Graduation-Project-2027/Framework-Subteam/RaspberryPi_ROS2/images/gui-mapping-bar.png

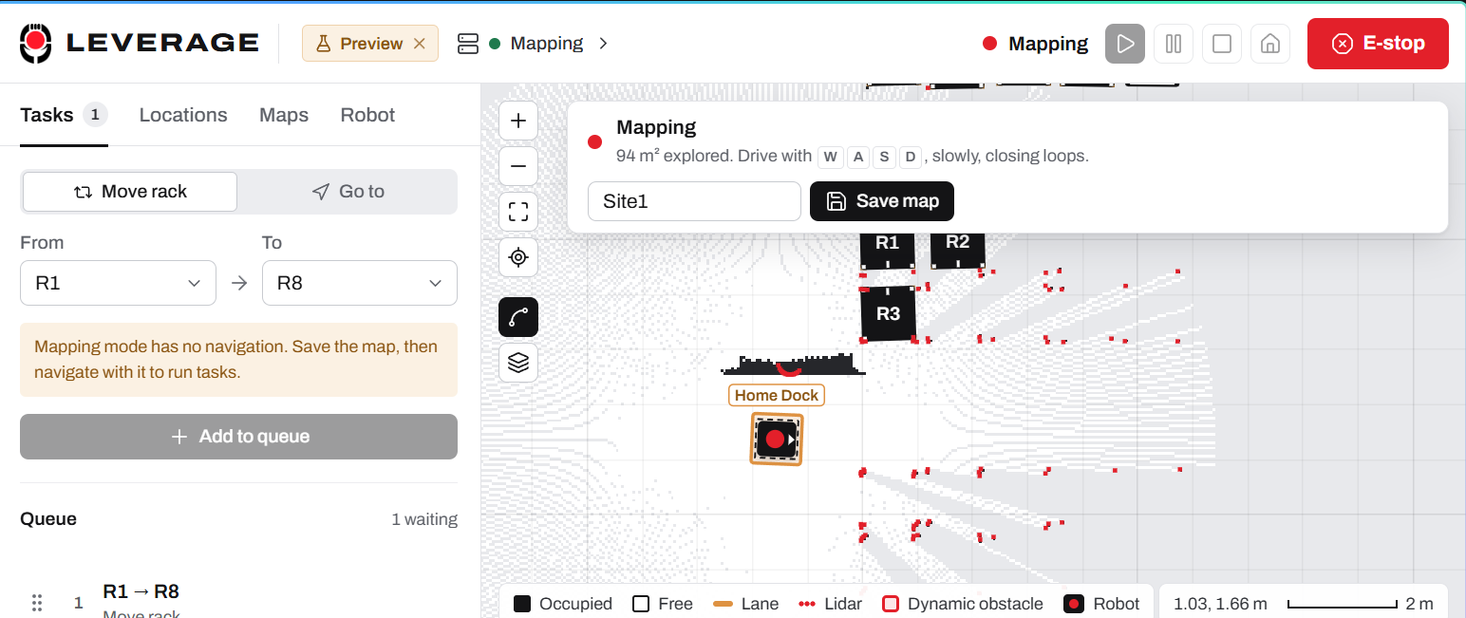
RaspberryPi_ROS2/images/gui-mapping-bar.png
