Graduation-Project-2027/Framework-Subteam/RaspberryPi_ROS2/images/gui-mapping-zoomed.png

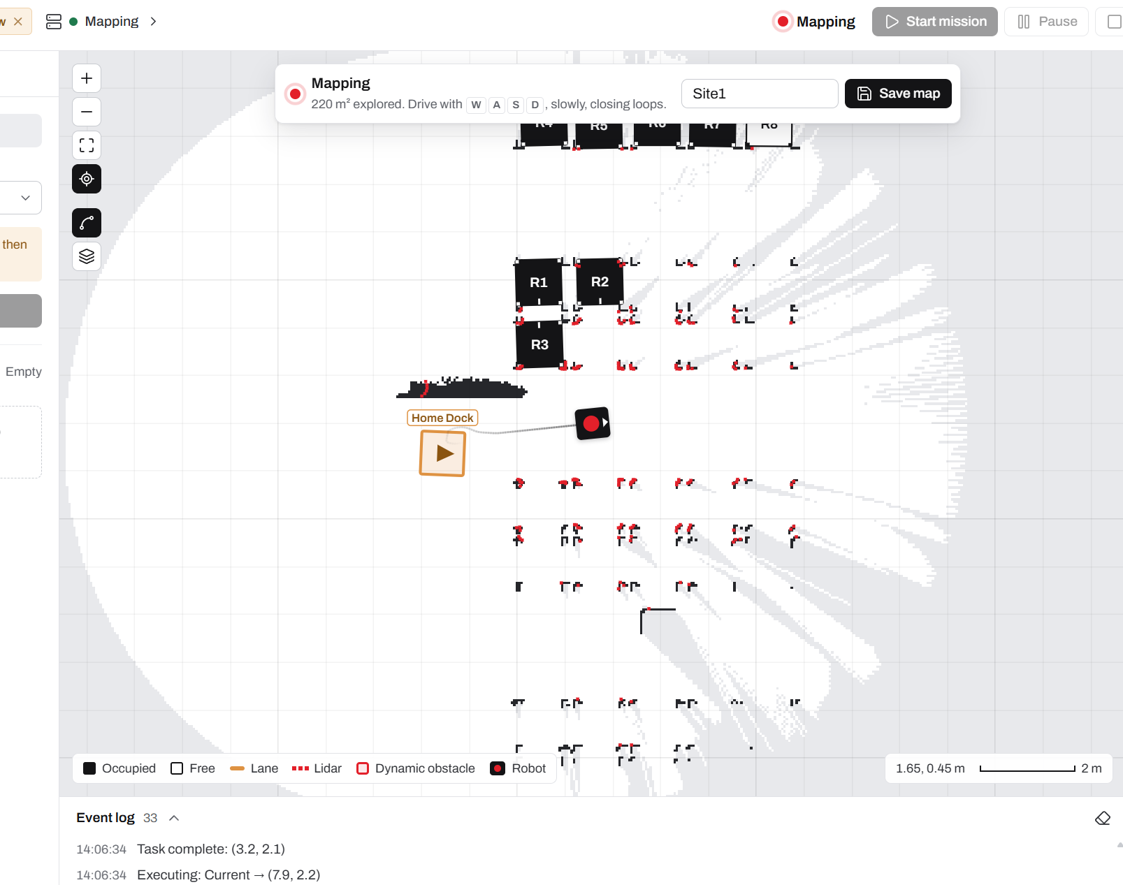
RaspberryPi_ROS2/images/gui-mapping-zoomed.png
