Graduation-Project-2027/Framework-Subteam/src/agv_description/models/loading_zone/materials/textures/loading_area.png

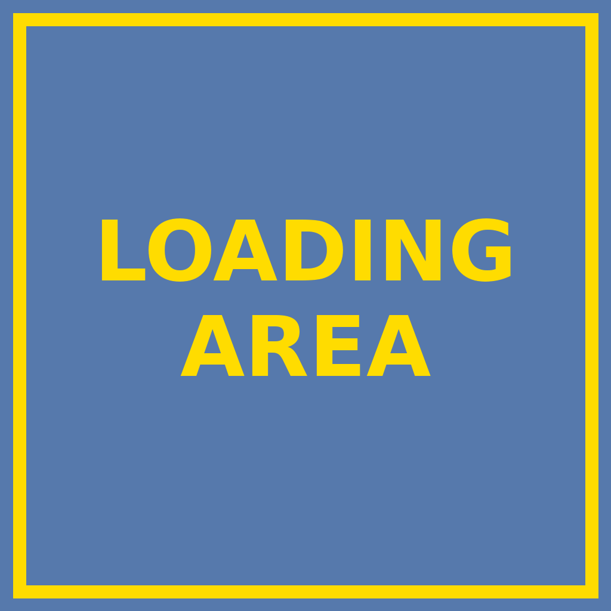
src/agv_description/models/loading_zone/materials/textures/loading_area.png
