Graduation-Project-2027/Framework-Subteam/RaspberryPi_ROS2/src/agv_description/meshes/lift_v2/bar1_back_left.STL

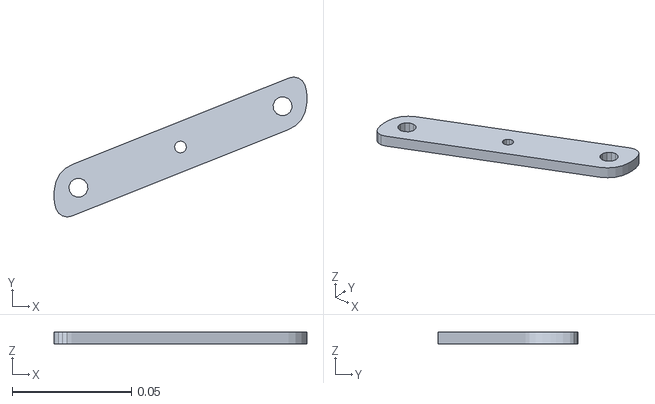
[picture p26: CAD file, 2026-10-28]
RaspberryPi_ROS2/src/agv_description/meshes/lift_v2/bar1_back_left.STL
0.106 x 0.0586 x 0.005
