Graduation-Project-2027/Framework-Subteam/src/mecanum_robot_description/meshes/robot_3d/visual/lifting_mechanism.stl

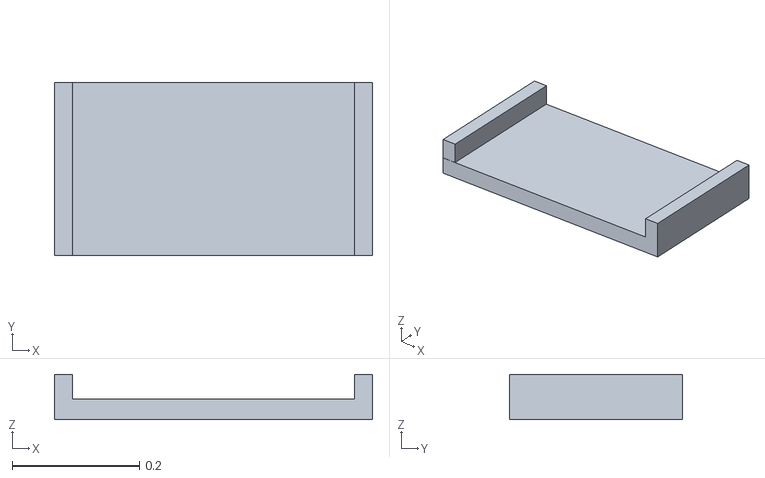
[picture p27: CAD file, 2026-03-07]
src/mecanum_robot_description/meshes/robot_3d/visual/lifting_mechanism.stl
0.501 x 0.273 x 0.0711
