Graduation-Project-2027/Framework-Subteam/RaspberryPi_ROS2/src/agv_description/meshes/lift_v2/base_link.STL

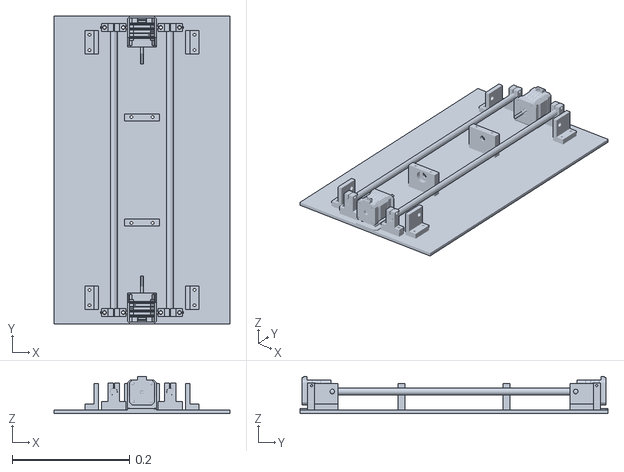
[picture p28: CAD file, 2026-10-28]
RaspberryPi_ROS2/src/agv_description/meshes/lift_v2/base_link.STL
0.3 x 0.525 x 0.0633
