Graduation-Project-2027/Framework-Subteam/src/mecanum_robot_description/meshes/robot_3d/visual/front_right_wheel_X3.STL

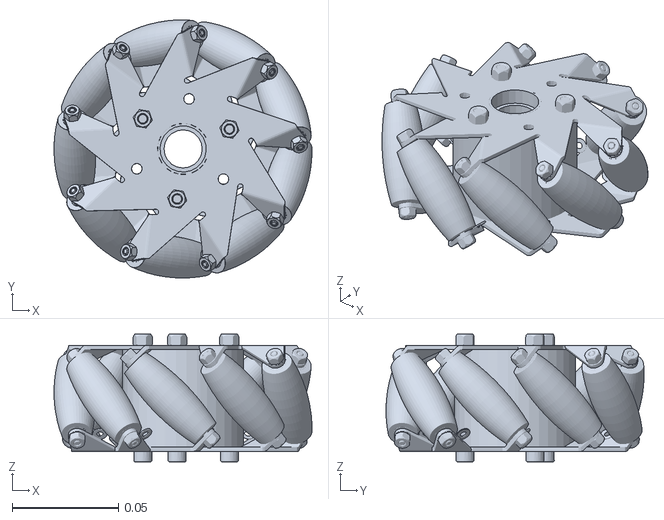
[picture p29: CAD file, 2026-03-05]
src/mecanum_robot_description/meshes/robot_3d/visual/front_right_wheel_X3.STL
0.122 x 0.122 x 0.0603
