Graduation-Project-2027/Framework-Subteam/src/New_Lift_Design/meshes/table_link.STL

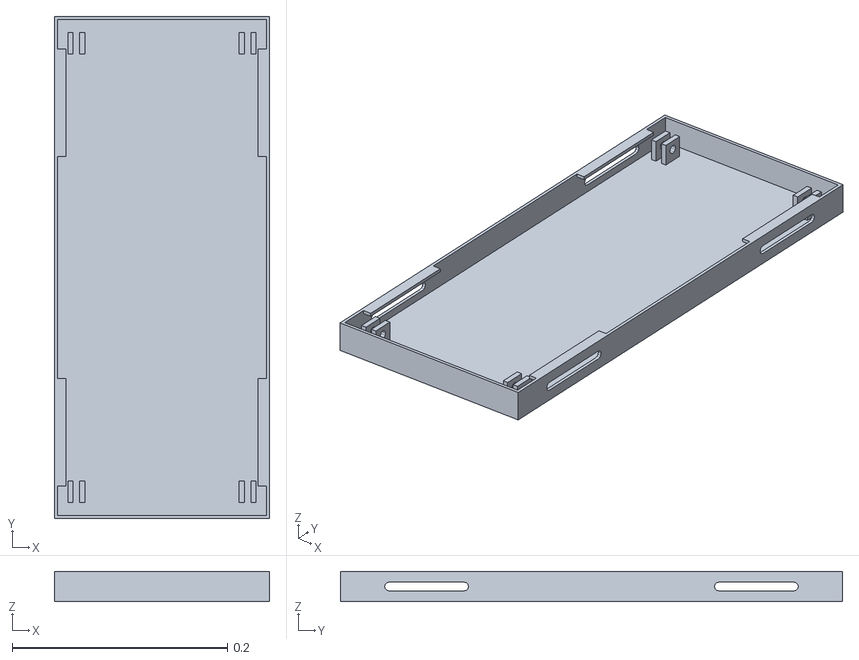
[picture p30: CAD file, 2026-06-20]
src/New_Lift_Design/meshes/table_link.STL
0.2 x 0.467 x 0.028
