Graduation-Project-2027/Framework-Subteam/RaspberryPi_ROS2/src/New_Lift_Design/meshes/lead_screw_left.STL

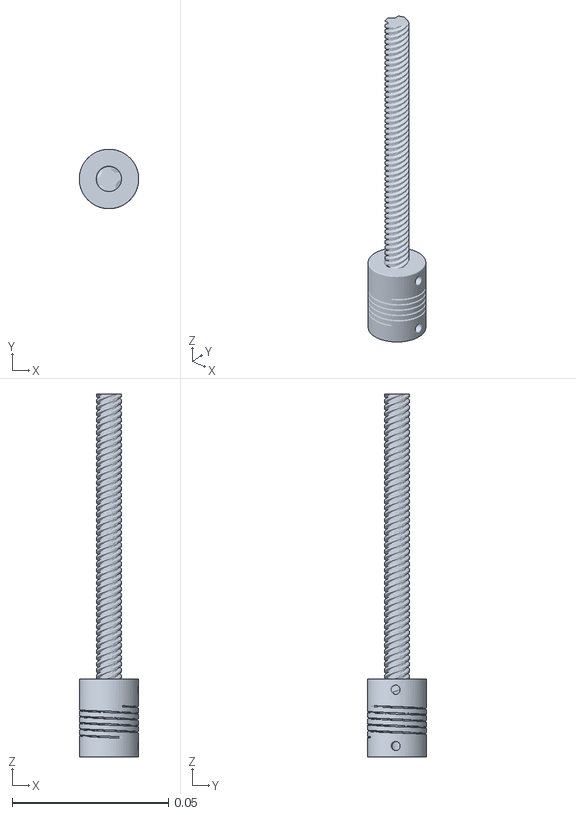
[picture p31: CAD file, 2026-10-28]
RaspberryPi_ROS2/src/New_Lift_Design/meshes/lead_screw_left.STL
0.019 x 0.019 x 0.116
