Graduation-Project-2027/Framework-Subteam/RaspberryPi_ROS2/src/amr_description/meshes/lift_v2/nut_left.STL

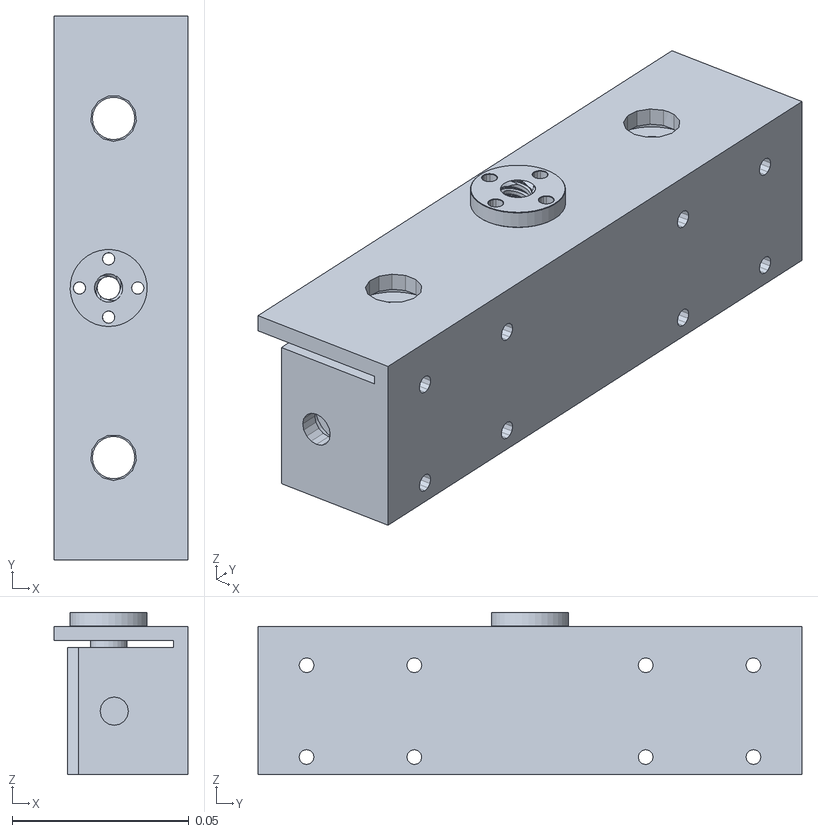
[picture p32: CAD file, 2026-10-28]
RaspberryPi_ROS2/src/amr_description/meshes/lift_v2/nut_left.STL
0.0378 x 0.154 x 0.046
