Graduation-Project-2027/Framework-Subteam/(list of files, cad)

Other CAD files:
RaspberryPi_ROS2/src/amr_description/meshes/lift_v2/bar2_back_right.STL
src/New_Lift_Design/meshes/bar2_front_right.STL
RaspberryPi_ROS2/src/New_Lift_Design/meshes/bar2_front_left.STL
src/agv_description/meshes/lift_v2/bar2_back_left.STL
RaspberryPi_ROS2/src/New_Lift_Design/meshes/bar1_back_right.STL
src/agv_description/meshes/lift_v2/bar1_front_right.STL
src/mecanum_robot_description/meshes/robot_3d/visual/back_right_wheel_X3.STL
src/New_Lift_Design/meshes/bar1_front_left.STL
src/mecanum_robot_description/meshes/robot_3d/visual/back_left_wheel_X3.STL
src/mecanum_robot_description/meshes/robot_3d/visual/front_left_wheel_X3.STL
src/agv_description/meshes/lift_v2/lead_screw_right.STL
OLD/mission_simulation/worlds/shelving_unit_warehouse.obj
src/New_Lift_Design/install_old/3dprototype_urdf/share/3dprototype_urdf/meshes/nut_right.STL
