Graduation-Project-2027/Framework-Subteam/RaspberryPi_ROS2/src/New_Lift_Design/build_old/3dprototype_urdf/install_manifest.txt

/home/omar/Desktop/3dprototype_urdf/install/3dprototype_urdf/share/3dprototype_urdf/config/joint_names_3dprototype_urdf.yaml
/home/omar/Desktop/3dprototype_urdf/install/3dprototype_urdf/share/3dprototype_urdf/launch/display.launch.py
/home/omar/Desktop/3dprototype_urdf/install/3dprototype_urdf/share/3dprototype_urdf/launch/gazebo.launch.py
/home/omar/Desktop/3dprototype_urdf/install/3dprototype_urdf/share/3dprototype_urdf/launch/__pycache__/display.launch.cpython-312.pyc
/home/omar/Desktop/3dprototype_urdf/install/3dprototype_urdf/share/3dprototype_urdf/launch/__pycache__/gazebo.launch.cpython-312.pyc
/home/omar/Desktop/3dprototype_urdf/install/3dprototype_urdf/share/3dprototype_urdf/meshes/base_link.STL
/home/omar/Desktop/3dprototype_urdf/install/3dprototype_urdf/share/3dprototype_urdf/meshes/nut_right.STL
/home/omar/Desktop/3dprototype_urdf/install/3dprototype_urdf/share/3dprototype_urdf/meshes/lead_screw_left.STL
/home/omar/Desktop/3dprototype_urdf/install/3dprototype_urdf/share/3dprototype_urdf/meshes/bar1_front_left.STL
/home/omar/Desktop/3dprototype_urdf/install/3dprototype_urdf/share/3dprototype_urdf/meshes/bar2_back_left.STL
/home/omar/Desktop/3dprototype_urdf/install/3dprototype_urdf/share/3dprototype_urdf/meshes/bar1_back_left.STL
/home/omar/Desktop/3dprototype_urdf/install/3dprototype_urdf/share/3dprototype_urdf/meshes/bar2_front_left.STL
/home/omar/Desktop/3dprototype_urdf/install/3dprototype_urdf/share/3dprototype_urdf/meshes/table_link.STL
/home/omar/Desktop/3dprototype_urdf/install/3dprototype_urdf/share/3dprototype_urdf/meshes/bar2_back_right.STL
/home/omar/Desktop/3dprototype_urdf/install/3dprototype_urdf/share/3dprototype_urdf/meshes/nut_left.STL
/home/omar/Desktop/3dprototype_urdf/install/3dprototype_urdf/share/3dprototype_urdf/meshes/bar1_front_right.STL
/home/omar/Desktop/3dprototype_urdf/install/3dprototype_urdf/share/3dprototype_urdf/meshes/lead_screw_right.STL
/home/omar/Desktop/3dprototype_urdf/install/3dprototype_urdf/share/3dprototype_urdf/meshes/bar2_front_right.STL
/home/omar/Desktop/3dprototype_urdf/install/3dprototype_urdf/share/3dprototype_urdf/meshes/bar1_back_right.STL
/home/omar/Desktop/3dprototype_urdf/install/3dprototype_urdf/share/3dprototype_urdf/rviz/urdf.rviz
/home/omar/Desktop/3dprototype_urdf/install/3dprototype_urdf/share/3dprototype_urdf/urdf/3dprototype_urdf.csv
/home/omar/Desktop/3dprototype_urdf/install/3dprototype_urdf/share/3dprototype_urdf/urdf/3dprototype_urdf.urdf
/home/omar/Desktop/3dprototype_urdf/install/3dprototype_urdf/share/3dprototype_urdf/urdf/3dprototype_urdf_control.urdf
/home/omar/Desktop/3dprototype_urdf/install/3dprototype_urdf/share/3dprototype_urdf/worlds/empty.sdf
/home/omar/Desktop/3dprototype_urdf/install/3dprototype_urdf/lib/3dprototype_urdf/scissor_mechanism_publisher.py
/home/omar/Desktop/3dprototype_urdf/install/3dprototype_urdf/share/3dprototype_urdf/package.xml
/home/omar/Desktop/3dprototype_urdf/install/3dprototype_urdf/share/ament_index/resource_index/packages/3dprototype_urdf
/home/omar/Desktop/3dprototype_urdf/install/3dprototype_urdf/share/ament_index/resource_index/package_run_dependencies/3dprototype_urdf
/home/omar/Desktop/3dprototype_urdf/install/3dprototype_urdf/share/ament_index/resource_index/parent_prefix_path/3dprototype_urdf
/home/omar/Desktop/3dprototype_urdf/install/3dprototype_urdf/share/3dprototype_urdf/environment/ament_prefix_path.sh
/home/omar/Desktop/3dprototype_urdf/install/3dprototype_urdf/share/3dprototype_urdf/environment/ament_prefix_path.dsv
/home/omar/Desktop/3dprototype_urdf/install/3dprototype_urdf/share/3dprototype_urdf/environment/path.sh
/home/omar/Desktop/3dprototype_urdf/install/3dprototype_urdf/share/3dprototype_urdf/environment/path.dsv
/home/omar/Desktop/3dprototype_urdf/install/3dprototype_urdf/share/3dprototype_urdf/local_setup.bash
/home/omar/Desktop/3dprototype_urdf/install/3dprototype_urdf/share/3dprototype_urdf/local_setup.sh
/home/omar/Desktop/3dprototype_urdf/install/3dprototype_urdf/share/3dprototype_urdf/local_setup.zsh
/home/omar/Desktop/3dprototype_urdf/install/3dprototype_urdf/share/3dprototype_urdf/local_setup.dsv
/home/omar/Desktop/3dprototype_urdf/install/3dprototype_urdf/share/3dprototype_urdf/package.dsv
/home/omar/Desktop/3dprototype_urdf/install/3dprototype_urdf/share/ament_index/resource_index/packages/3dprototype_urdf
/home/omar/Desktop/3dprototype_urdf/install/3dprototype_urdf/share/3dprototype_urdf/cmake/3dprototype_urdfConfig.cmake
/home/omar/Desktop/3dprototype_urdf/install/3dprototype_urdf/share/3dprototype_urdf/cmake/3dprototype_urdfConfig-version.cmake
/home/omar/Desktop/3dprototype_urdf/install/3dprototype_urdf/share/3dprototype_urdf/package.xml
