Graduation-Project-2027/Framework-Subteam/src/agv_description/urdf/urdf/temp.urdf

<?xml version="1.0" ?>
<!-- =================================================================================== -->
<!-- |    This document was autogenerated by xacro from robot.urdf.xacro               | -->
<!-- |    EDITING THIS FILE BY HAND IS NOT RECOMMENDED                                 | -->
<!-- =================================================================================== -->
<robot name="agv" xmlns:gz="http://gazebosim.org/schema">
  <material name="black">
    <color rgba="0.0 0.0 0.0 1.0"/>
  </material>
  <material name="blue">
    <color rgba="0.0 0.0 0.8 1.0"/>
  </material>
  <material name="green">
    <color rgba="0.0 0.8 0.0 1.0"/>
  </material>
  <material name="grey">
    <color rgba="0.2 0.2 0.2 1.0"/>
  </material>
  <material name="orange">
    <color rgba="1.0 0.4235294117647059 0.0392156862745098 1.0"/>
  </material>
  <material name="brown">
    <color rgba="0.8705882352941177 0.8117647058823529 0.7647058823529411 1.0"/>
  </material>
  <material name="red">
    <color rgba="0.8 0.0 0.0 1.0"/>
  </material>
  <material name="white">
    <color rgba="1.0 1.0 1.0 1.0"/>
  </material>
  <link name="base_footprint"/>
  <link name="base_link">
    <visual>
      <geometry>
        <mesh filename="file:///home/som3a-station/prjs/Grad/Framework-Subteam/install/agv_description/share/agv_description/meshes/robot_3d/visual/base_link.STL"/>
      </geometry>
      <material name="white">
        <color rgba="1 1 1 1"/>
      </material>
      <origin rpy="0 0 0" xyz="0 0 0"/>
    </visual>
    <collision>
      <geometry>
        <box size="0.7 0.51984 0.18"/>
      </geometry>
      <origin rpy="0 0 0" xyz="0.0 0 0.09"/>
    </collision>
    <inertial>
      <origin rpy="0 0 0" xyz="0.0 0 0.06968333333333333"/>
      <mass value="20"/>
      <inertia ixx="0.5043893759999999" ixy="0.0" ixz="0.0" iyy="0.8706666666666666" iyz="0.0" izz="1.2670560426666664"/>
    </inertial>
  </link>
  <gazebo reference="base_link">
    <visual>
      <material>
        <ambient>0 0.7 0 1</ambient>
        <diffuse>0 0.7 0 1</diffuse>
        <specular>0 0.7 0 1</specular>
      </material>
    </visual>
  </gazebo>
  <joint name="base_joint" type="fixed">
    <parent link="base_footprint"/>
    <child link="base_link"/>
    <origin rpy="0 0 0" xyz="0 0 0.035739999999999994"/>
  </joint>
  <link name="lift_link">
    <visual>
      <origin rpy="0 0 0" xyz="0 -0.25 0"/>
      <geometry>
        <mesh filename="file:///home/som3a-station/prjs/Grad/Framework-Subteam/install/agv_description/share/agv_description/meshes/robot_3d/visual/lifting_mechanism.stl"/>
      </geometry>
      <material name="silver">
        <color rgba="0.75 0.75 0.75 1"/>
      </material>
    </visual>
    <collision>
      <origin rpy="0 0 0" xyz="0 -0.25 0"/>
      <geometry>
        <mesh filename="file:///home/som3a-station/prjs/Grad/Framework-Subteam/install/agv_description/share/agv_description/meshes/robot_3d/visual/lifting_mechanism.stl"/>
      </geometry>
    </collision>
    <inertial>
      <origin rpy="0 0 0" xyz="0 0 0"/>
      <mass value="5.0"/>
      <inertia ixx="0.05" ixy="0" ixz="0" iyy="0.05" iyz="0" izz="0.05"/>
    </inertial>
  </link>
  <joint name="lift_joint" type="prismatic">
    <parent link="base_link"/>
    <child link="lift_link"/>
    <origin rpy="0 0 0" xyz="0 0 0.15"/>
    <axis xyz="0 0 1"/>
    <limit effort="200" lower="0" upper="0.5" velocity="0.2"/>
    <dynamics damping="15.0" friction="2.0"/>
  </joint>
  <transmission name="lift_trans">
    <type>transmission_interface/SimpleTransmission</type>
    <joint name="lift_joint">
      <hardwareInterface>hardware_interface/PositionJointInterface</hardwareInterface>
    </joint>
    <actuator name="lift_motor">
      <mechanicalReduction>1</mechanicalReduction>
    </actuator>
  </transmission>
  <gazebo reference="lift_link">
    <material>Gazebo/Grey</material>
  </gazebo>
  <link name="front_left_wheel_link">
    <visual>
      <origin rpy="0 0 0" xyz="0 0 -0.025"/>
      <geometry>
        <mesh filename="file:///home/som3a-station/prjs/Grad/Framework-Subteam/install/agv_description/share/agv_description/meshes/robot_3d/visual/front_left_wheel_X3.STL" scale="1 1 1"/>
      </geometry>
      <material name="dark_gray">
        <color rgba="0.2 0.2 0.2 1.0"/>
      </material>
    </visual>
    <collision>
      <origin rpy="0 0 0" xyz="0.0 0 0.025"/>
      <geometry>
        <cylinder length="0.06" radius="0.06095"/>
      </geometry>
    </collision>
    <inertial>
      <origin rpy="0 0 0" xyz="0.0 0 0"/>
      <mass value="2"/>
      <inertia ixx="0.0024574512499999997" ixy="0" ixz="0" iyy="0.0037149024999999997" iyz="0" izz="0.0024574512499999997"/>
    </inertial>
  </link>
  <joint name="front_left_wheel_joint" type="continuous">
    <axis xyz="0 0 -1"/>
    <parent link="base_link"/>
    <child link="front_left_wheel_link"/>
    <origin rpy="1.5707963267948966 1.5707963267948966 0" xyz="0.283 0.29491999999999996 0.02521"/>
  </joint>
  <gazebo reference="front_left_wheel_link">
    <surface>
      <friction>
        <ode>
          <mu>2.0</mu>
          <mu2>0.0</mu2>
        </ode>
      </friction>
    </surface>
    <visual>
      <material>
        <ambient>0.2 0.2 0.2 1.0</ambient>
        <diffuse>0.2 0.2 0.2 1.0</diffuse>
        <specular>0.2 0.2 0.2 1.0</specular>
        <emissive>0.0 0.0 0.0 0.0</emissive>
      </material>
    </visual>
  </gazebo>
  <link name="front_right_wheel_link">
    <visual>
      <origin rpy="0 0 0" xyz="0 0 -0.025"/>
      <geometry>
        <mesh filename="file:///home/som3a-station/prjs/Grad/Framework-Subteam/install/agv_description/share/agv_description/meshes/robot_3d/visual/front_right_wheel_X3.STL" scale="1 1 1"/>
      </geometry>
      <material name="dark_gray">
        <color rgba="0.2 0.2 0.2 1.0"/>
      </material>
    </visual>
    <collision>
      <origin rpy="0 0 0" xyz="0.0 0 0.025"/>
      <geometry>
        <cylinder length="0.06" radius="0.06095"/>
      </geometry>
    </collision>
    <inertial>
      <origin rpy="0 0 0" xyz="0.0 0 0"/>
      <mass value="2"/>
      <inertia ixx="0.0024574512499999997" ixy="0" ixz="0" iyy="0.0037149024999999997" iyz="0" izz="0.0024574512499999997"/>
    </inertial>
  </link>
  <joint name="front_right_wheel_joint" type="continuous">
    <axis xyz="0 0 1"/>
    <parent link="base_link"/>
    <child link="front_right_wheel_link"/>
    <origin rpy="-1.5707963267948966 1.5707963267948966 0" xyz="0.283 -0.29491999999999996 0.02521"/>
  </joint>
  <gazebo reference="front_right_wheel_link">
    <surface>
      <friction>
        <ode>
          <mu>2.0</mu>
          <mu2>0.0</mu2>
        </ode>
      </friction>
    </surface>
    <visual>
      <material>
        <ambient>0.2 0.2 0.2 1.0</ambient>
        <diffuse>0.2 0.2 0.2 1.0</diffuse>
        <specular>0.2 0.2 0.2 1.0</specular>
        <emissive>0.0 0.0 0.0 0.0</emissive>
      </material>
    </visual>
  </gazebo>
  <link name="back_left_wheel_link">
    <visual>
      <origin rpy="0 0 0" xyz="0 0 -0.025"/>
      <geometry>
        <mesh filename="file:///home/som3a-station/prjs/Grad/Framework-Subteam/install/agv_description/share/agv_description/meshes/robot_3d/visual/back_left_wheel_X3.STL" scale="1 1 1"/>
      </geometry>
      <material name="dark_gray">
        <color rgba="0.2 0.2 0.2 1.0"/>
      </material>
    </visual>
    <collision>
      <origin rpy="0 0 0" xyz="0.0 0 0.025"/>
      <geometry>
        <cylinder length="0.06" radius="0.06095"/>
      </geometry>
    </collision>
    <inertial>
      <origin rpy="0 0 0" xyz="0.0 0 0"/>
      <mass value="2"/>
      <inertia ixx="0.0024574512499999997" ixy="0" ixz="0" iyy="0.0037149024999999997" iyz="0" izz="0.0024574512499999997"/>
    </inertial>
  </link>
  <joint name="back_left_wheel_joint" type="continuous">
    <axis xyz="0 0 -1"/>
    <parent link="base_link"/>
    <child link="back_left_wheel_link"/>
    <origin rpy="1.5707963267948966 1.5707963267948966 0" xyz="-0.283 0.29491999999999996 0.02521"/>
  </joint>
  <gazebo reference="back_left_wheel_link">
    <surface>
      <friction>
        <ode>
          <mu>2.0</mu>
          <mu2>0.0</mu2>
        </ode>
      </friction>
    </surface>
    <visual>
      <material>
        <ambient>0.2 0.2 0.2 1.0</ambient>
        <diffuse>0.2 0.2 0.2 1.0</diffuse>
        <specular>0.2 0.2 0.2 1.0</specular>
        <emissive>0.0 0.0 0.0 0.0</emissive>
      </material>
    </visual>
  </gazebo>
  <link name="back_right_wheel_link">
    <visual>
      <origin rpy="0 0 0" xyz="0 0 -0.025"/>
      <geometry>
        <mesh filename="file:///home/som3a-station/prjs/Grad/Framework-Subteam/install/agv_description/share/agv_description/meshes/robot_3d/visual/back_right_wheel_X3.STL" scale="1 1 1"/>
      </geometry>
      <material name="dark_gray">
        <color rgba="0.2 0.2 0.2 1.0"/>
      </material>
    </visual>
    <collision>
      <origin rpy="0 0 0" xyz="0.0 0 0.025"/>
      <geometry>
        <cylinder length="0.06" radius="0.06095"/>
      </geometry>
    </collision>
    <inertial>
      <origin rpy="0 0 0" xyz="0.0 0 0"/>
      <mass value="2"/>
      <inertia ixx="0.0024574512499999997" ixy="0" ixz="0" iyy="0.0037149024999999997" iyz="0" izz="0.0024574512499999997"/>
    </inertial>
  </link>
  <joint name="back_right_wheel_joint" type="continuous">
    <axis xyz="0 0 1"/>
    <parent link="base_link"/>
    <child link="back_right_wheel_link"/>
    <origin rpy="-1.5707963267948966 1.5707963267948966 0" xyz="-0.283 -0.29491999999999996 0.02521"/>
  </joint>
  <gazebo reference="back_right_wheel_link">
    <surface>
      <friction>
        <ode>
          <mu>2.0</mu>
          <mu2>0.0</mu2>
        </ode>
      </friction>
    </surface>
    <visual>
      <material>
        <ambient>0.2 0.2 0.2 1.0</ambient>
        <diffuse>0.2 0.2 0.2 1.0</diffuse>
        <specular>0.2 0.2 0.2 1.0</specular>
        <emissive>0.0 0.0 0.0 0.0</emissive>
      </material>
    </visual>
  </gazebo>
  <!-- 2.5.3 Lidar physical properties -->
  <link name="laser_frame">
    <visual>
      <origin rpy="0 0 0" xyz="0 0 0"/>
      <geometry>
        <mesh filename="package://agv_description/meshes/robot_3d/visual/laser_link.STL" scale="1 1 1"/>
      </geometry>
      <material name="rplidar_black">
        <color rgba="0.1 0.1 0.1 1"/>
      </material>
    </visual>
    <inertial>
      <mass value="0.185"/>
      <origin rpy="0 0 0" xyz="0 0 0"/>
      <inertia ixx="9.297467916666665e-05" ixy="0.0" ixz="0.0" iyy="9.297467916666665e-05" iyz="0.0" izz="0.000137108125"/>
    </inertial>
  </link>
  <joint name="laser_frame_joint" type="fixed">
    <parent link="base_link"/>
    <child link="laser_frame"/>
    <origin rpy="0 0 0" xyz="0.29 0 0.15"/>
  </joint>
  <!-- 2.5.3 IMU gz sim properties -->
  <gazebo reference="laser_frame">
    <material>
      <ambient>0.1 0.1 0.1 1</ambient>
      <diffuse>0.1 0.1 0.1 1</diffuse>
      <specular>0.1 0.1 0.1 1</specular>
    </material>
    <sensor name="lidar_sensor" type="gpu_lidar">
      <topic>scan</topic>
      <update_rate>10</update_rate>
      <always_on>True</always_on>
      <visualize>False</visualize>
      <lidar>
        <scan>
          <horizontal>
            <samples>720</samples>
            <resolution>1</resolution>
            <min_angle>-3.14159</min_angle>
            <max_angle>3.14159</max_angle>
          </horizontal>
          <vertical>
            <samples>1</samples>
            <resolution>1</resolution>
            <min_angle>0</min_angle>
            <max_angle>0</max_angle>
          </vertical>
          <!-- <vertical>
              <samples>32</samples>
              <min_angle>-0.5353</min_angle>
              <max_angle>0.1862</max_angle>
            </vertical> -->
        </scan>
        <range>
          <min>0.50</min>
          <max>30.0</max>
          <resolution>0.013</resolution>
        </range>
      </lidar>
      <gz_frame_id>laser_frame</gz_frame_id>
    </sensor>
  </gazebo>
  <!-- 2.5.2 IMU physical properties -->
  <link name="imu_link">
    <visual>
      <origin rpy="0 0 0" xyz="0 0 0"/>
      <geometry>
        <box size="0.03899 0.03785 0.01338"/>
      </geometry>
      <material name="imu_black">
        <color rgba="0.1 0.1 0.1 1"/>
      </material>
    </visual>
    <inertial>
      <mass value="0.031"/>
      <origin rpy="0 0 0" xyz="0 0 0"/>
      <inertia ixx="4.163421158333333e-06" ixy="0.0" ixz="0.0" iyy="4.389714958333333e-06" iyz="0.0" izz="7.6281767166666665e-06"/>
    </inertial>
  </link>
  <joint name="imu_joint" type="fixed">
    <parent link="base_link"/>
    <child link="imu_link"/>
    <origin rpy="0 0 0" xyz="0 0 0.016"/>
  </joint>
  <!-- 2.5.2 IMU gz sim properties -->
  <gazebo reference="imu_link">
    <material>
      <ambient>0.1 0.1 0.1 1</ambient>
      <diffuse>0.1 0.1 0.1 1</diffuse>
      <specular>0.1 0.1 0.1 1</specular>
    </material>
    <sensor name="imu_sensor" type="imu">
      <topic>imu/data</topic>
      <update_rate>15.0</update_rate>
      <always_on>True</always_on>
      <visualize>False</visualize>
      <gz_frame_id>imu_link</gz_frame_id>
    </sensor>
  </gazebo>
</robot>
