Graduation-Project-2027/Framework-Subteam/RaspberryPi_ROS2/src/amr_navigation/config/navigation.yaml

bt_navigator:
  ros__parameters:
    global_frame: map
    robot_base_frame: base_footprint
    odom_topic: /odometry/filtered
    bt_loop_duration: 10
    default_server_timeout: 120
    wait_for_service_timeout: 1000
    action_server_result_timeout: 900.0
    navigators: ["navigate_to_pose", "navigate_through_poses"]
    navigate_to_pose:
      plugin: "nav2_bt_navigator::NavigateToPoseNavigator"
    navigate_through_poses:
      plugin: "nav2_bt_navigator::NavigateThroughPosesNavigator"

    error_code_names:
      - compute_path_error_code
      - follow_path_error_code

controller_server:
  ros__parameters:
    controller_frequency: 10.0
    costmap_update_timeout: 0.30
    min_x_velocity_threshold: 0.001
    min_y_velocity_threshold: 0.001
    min_theta_velocity_threshold: 0.001
    failure_tolerance: 0.3
    progress_checker_plugins: ["progress_checker"]
    goal_checker_plugins: ["general_goal_checker"]
    controller_plugins: ["FollowPath"]
    use_realtime_priority: false

    progress_checker:
      plugin: "nav2_controller::SimpleProgressChecker"
      required_movement_radius: 0.5
      movement_time_allowance: 10.0
    general_goal_checker:
      stateful: False
      plugin: "nav2_controller::SimpleGoalChecker"
      # Tighter tolerances so the robot actually reaches staging points
      # under racks/drops accurately.  At 0.25 m the closed-loop crawl
      # could not always close the gap because Nav2 would declare
      # success while still well short of the goal.
      xy_goal_tolerance: 0.08
      yaw_goal_tolerance: 0.10
    FollowPath:
      plugin: "nav2_mppi_controller::MPPIController"
      time_steps: 28
      model_dt: 0.1
      batch_size: 1000
      ax_max: 2.5
      ax_min: -2.5
      az_max: 3.5
      vx_std: 0.3
      wz_std: 0.3
      vx_max: 0.5
      vx_min: -0.3
      wz_max: 1.2
      iteration_count: 1
      prune_distance: 1.2
      transform_tolerance: 0.1
      temperature: 0.3
      gamma: 0.015
      motion_model: "DiffDrive"
      visualize: false
      regenerate_noises: false
      TrajectoryVisualizer:
        trajectory_step: 5
        time_step: 3
      TrajectoryValidator:
        plugin: "mppi::DefaultOptimalTrajectoryValidator"
        collision_lookahead_time: 2.0
        consider_footprint: true
      critics: [
        "ConstraintCritic", "CostCritic", "GoalCritic",
        "GoalAngleCritic", "PathAlignCritic", "PathFollowCritic",
        "PathAngleCritic", "PreferForwardCritic"]
      ConstraintCritic:
        enabled: true
        cost_power: 1
        cost_weight: 4.0
      GoalCritic:
        enabled: true
        cost_power: 1
        cost_weight: 5.0
        threshold_to_consider: 1.4
      GoalAngleCritic:
        enabled: true
        cost_power: 1
        cost_weight: 5.0
        threshold_to_consider: 1.4
      PreferForwardCritic:
        enabled: true
        cost_power: 1
        cost_weight: 15.0
        threshold_to_consider: 0.5
      CostCritic:
        enabled: true
        cost_power: 1
        cost_weight: 12.0
        critical_cost: 300.0
        consider_footprint: true
        collision_cost: 1000000.0
        near_goal_distance: 1.0
        trajectory_point_step: 2
      PathAlignCritic:
        enabled: true
        cost_power: 1
        cost_weight: 14.0
        max_path_occupancy_ratio: 0.05
        trajectory_point_step: 4
        threshold_to_consider: 0.5
        offset_from_furthest: 20
        use_path_orientations: false
      PathFollowCritic:
        enabled: true
        cost_power: 1
        cost_weight: 5.0
        offset_from_furthest: 5
        threshold_to_consider: 1.4
      PathAngleCritic:
        enabled: true
        cost_power: 1
        cost_weight: 2.0
        offset_from_furthest: 4
        threshold_to_consider: 0.35
        max_angle_to_furthest: 1.0
        mode: 0

local_costmap:
  local_costmap:
    ros__parameters:
      update_frequency: 5.0
      publish_frequency: 2.0
      global_frame: odom
      robot_base_frame: base_footprint
      rolling_window: true
      width: 3
      height: 3
      resolution: 0.05
      footprint: "[[0.35, 0.32], [0.35, -0.32], [-0.35, -0.32], [-0.35, 0.32]]"
      footprint_padding: 0.03
      plugins: ["voxel_layer", "fleet_layer", "inflation_layer"]
      # Other robots of the fleet, relayed by fleet_server.py on the laptop
      # (each peer's footprint, published in this robot's base_footprint
      # frame). Its own layer, so the far clearing rays in the same cloud
      # only wipe stale peer marks, never what the lidars see. Silent when
      # no fleet manager runs.
      fleet_layer:
        plugin: "nav2_costmap_2d::ObstacleLayer"
        enabled: True
        observation_sources: fleet
        fleet:
          topic: /fleet/peers
          data_type: "PointCloud2"
          marking: True
          clearing: True
          min_obstacle_height: 0.0
          max_obstacle_height: 2.0
          obstacle_max_range: 12.0
          obstacle_min_range: 0.0
          raytrace_max_range: 15.0
          raytrace_min_range: 0.0
          expected_update_rate: 0.0
      inflation_layer:
        plugin: "nav2_costmap_2d::InflationLayer"
        cost_scaling_factor: 1.5
        inflation_radius: 0.55
      voxel_layer:
        plugin: "nav2_costmap_2d::VoxelLayer"
        enabled: True
        publish_voxel_map: True
        origin_z: 0.0
        z_resolution: 0.05
        z_voxels: 16
        max_obstacle_height: 2.0
        mark_threshold: 0
        observation_sources: scan_front scan_rear rack_obstacles
        scan_front:
          # Payload-filtered scan (carried rack legs removed while lifting).
          topic: /scan_front_nav
          max_obstacle_height: 2.0
          clearing: True
          marking: True
          data_type: "LaserScan"
          raytrace_max_range: 3.0
          raytrace_min_range: 0.0
          obstacle_max_range: 2.5
          obstacle_min_range: 0.0
        scan_rear:
          topic: /scan_rear_nav
          max_obstacle_height: 2.0
          clearing: True
          marking: True
          data_type: "LaserScan"
          raytrace_max_range: 3.0
          raytrace_min_range: 0.0
          obstacle_max_range: 2.5
          obstacle_min_range: 0.0
        # Dynamic rack obstacles (published by mission_manager).
        # marking only — clearing is driven by the mission state, not raytracing.
        rack_obstacles:
          topic: /rack_obstacles
          max_obstacle_height: 2.0
          clearing: False
          marking: True
          data_type: "PointCloud2"
          obstacle_max_range: 100.0
          obstacle_min_range: 0.0
      static_layer:
        plugin: "nav2_costmap_2d::StaticLayer"
        map_subscribe_transient_local: True
      always_send_full_costmap: True

global_costmap:
  global_costmap:
    ros__parameters:
      update_frequency: 1.0
      publish_frequency: 1.0
      global_frame: map
      robot_base_frame: base_footprint
      footprint: "[[0.35, 0.32], [0.35, -0.32], [-0.35, -0.32], [-0.35, 0.32]]"
      footprint_padding: 0.03
      resolution: 0.05
      track_unknown_space: true
      plugins: ["static_layer", "obstacle_layer", "fleet_layer", "inflation_layer"]
      # Other robots of the fleet, relayed by fleet_server.py on the laptop
      # (each peer's footprint, published in this robot's base_footprint
      # frame). Its own layer, so the far clearing rays in the same cloud
      # only wipe stale peer marks, never what the lidars see. Silent when
      # no fleet manager runs.
      fleet_layer:
        plugin: "nav2_costmap_2d::ObstacleLayer"
        enabled: True
        observation_sources: fleet
        fleet:
          topic: /fleet/peers
          data_type: "PointCloud2"
          marking: True
          clearing: True
          min_obstacle_height: 0.0
          max_obstacle_height: 2.0
          obstacle_max_range: 12.0
          obstacle_min_range: 0.0
          raytrace_max_range: 15.0
          raytrace_min_range: 0.0
          expected_update_rate: 0.0
      obstacle_layer:
        plugin: "nav2_costmap_2d::ObstacleLayer"
        enabled: True
        observation_sources: scan_front scan_rear rack_obstacles
        scan_front:
          # Payload-filtered scan (carried rack legs removed while lifting).
          topic: /scan_front_nav
          max_obstacle_height: 2.0
          clearing: True
          marking: True
          data_type: "LaserScan"
          raytrace_max_range: 3.0
          raytrace_min_range: 0.0
          obstacle_max_range: 2.5
          obstacle_min_range: 0.0
        scan_rear:
          topic: /scan_rear_nav
          max_obstacle_height: 2.0
          clearing: True
          marking: True
          data_type: "LaserScan"
          raytrace_max_range: 3.0
          raytrace_min_range: 0.0
          obstacle_max_range: 2.5
          obstacle_min_range: 0.0
        rack_obstacles:
          topic: /rack_obstacles
          max_obstacle_height: 2.0
          clearing: False
          marking: True
          data_type: "PointCloud2"
          obstacle_max_range: 100.0
          obstacle_min_range: 0.0
      static_layer:
        plugin: "nav2_costmap_2d::StaticLayer"
        map_subscribe_transient_local: True
        # navigation.launch.py rewrites this to /map_static (the saved, possibly
        # GUI-edited map image) when the map has a .yaml; /map is the live SLAM map.
        map_topic: map
      inflation_layer:
        plugin: "nav2_costmap_2d::InflationLayer"
        cost_scaling_factor: 1.5
        inflation_radius: 0.55
      always_send_full_costmap: True

planner_server:
  ros__parameters:
    expected_planner_frequency: 20.0
    planner_plugins: ["GridBased"]
    costmap_update_timeout: 1.0
    GridBased:
      plugin: "nav2_navfn_planner::NavfnPlanner"
      tolerance: 0.5
      use_astar: true
      allow_unknown: true

smoother_server:
  ros__parameters:
    smoother_plugins: ["simple_smoother"]
    simple_smoother:
      plugin: "nav2_smoother::SimpleSmoother"
      tolerance: 1.0e-10
      max_its: 1000
      do_refinement: True

behavior_server:
  ros__parameters:
    local_costmap_topic: local_costmap/costmap_raw
    global_costmap_topic: global_costmap/costmap_raw
    local_footprint_topic: local_costmap/published_footprint
    global_footprint_topic: global_costmap/published_footprint
    cycle_frequency: 10.0
    behavior_plugins: ["spin", "backup", "drive_on_heading", "assisted_teleop", "wait"]
    spin:
      plugin: "nav2_behaviors::Spin"
    backup:
      plugin: "nav2_behaviors::BackUp"
    drive_on_heading:
      plugin: "nav2_behaviors::DriveOnHeading"
    wait:
      plugin: "nav2_behaviors::Wait"
    assisted_teleop:
      plugin: "nav2_behaviors::AssistedTeleop"
    local_frame: odom
    global_frame: map
    robot_base_frame: base_footprint
    transform_tolerance: 0.1
    simulate_ahead_time: 2.0
    max_rotational_vel: 1.0
    min_rotational_vel: 0.4
    rotational_acc_lim: 3.2

waypoint_follower:
  ros__parameters:
    loop_rate: 20
    stop_on_failure: false
    action_server_result_timeout: 900.0
    waypoint_task_executor_plugin: "wait_at_waypoint"
    wait_at_waypoint:
      plugin: "nav2_waypoint_follower::WaitAtWaypoint"
      enabled: True
      waypoint_pause_duration: 200

velocity_smoother:
  ros__parameters:
    smoothing_frequency: 20.0
    scale_velocities: False
    feedback: "OPEN_LOOP"
    max_velocity: [0.5, 0.0, 1.2]
    min_velocity: [-0.3, 0.0, -1.2]
    max_accel: [2.5, 2.5, 3.2]
    max_decel: [-2.5, -2.5, -3.2]
    odom_topic: "/odometry/filtered"
    odom_duration: 0.1
    deadband_velocity: [0.0, 0.0, 0.0]
    velocity_timeout: 1.0

collision_monitor:
  ros__parameters:
    base_frame_id: "base_footprint"
    odom_frame_id: "odom"
    cmd_vel_in_topic: "cmd_vel_smoothed"
    cmd_vel_out_topic: "cmd_vel"
    state_topic: "collision_monitor_state"
    transform_tolerance: 0.2
    source_timeout: 1.0
    base_shift_correction: True
    stop_pub_timeout: 2.0
    polygons: ["FootprintApproach"]
    FootprintApproach:
      type: "polygon"
      action_type: "approach"
      footprint_topic: "/local_costmap/published_footprint"
      time_before_collision: 1.2
      simulation_time_step: 0.1
      min_points: 6
      visualize: False
      enabled: False
    observation_sources: ["scan_front", "scan_rear"]
    scan_front:
      type: "scan"
      topic: "/scan_front_filtered"
      min_height: 0.15
      max_height: 2.0
      enabled: False
    scan_rear:
      type: "scan"
      topic: "/scan_rear_filtered"
      min_height: 0.15
      max_height: 2.0
      enabled: False

docking_server:
  ros__parameters:
    controller_frequency: 50.0
    initial_perception_timeout: 5.0
    wait_charge_timeout: 5.0
    dock_approach_timeout: 30.0
    undock_linear_tolerance: 0.05
    undock_angular_tolerance: 0.1
    max_retries: 3
    base_frame: "base_footprint"
    fixed_frame: "odom"
    dock_backwards: false
    dock_prestaging_tolerance: 0.5

    dock_plugins: ['simple_charging_dock']
    simple_charging_dock:
      plugin: 'opennav_docking::SimpleChargingDock'
      docking_threshold: 0.05
      staging_x_offset: -0.7
      use_external_detection_pose: true
      use_battery_status: false
      use_stall_detection: false

      external_detection_timeout: 1.0
      external_detection_translation_x: -0.18
      external_detection_translation_y: 0.0
      external_detection_rotation_roll: -1.57
      external_detection_rotation_pitch: -1.57
      external_detection_rotation_yaw: 0.0
      filter_coef: 0.1

    controller:
      k_phi: 6.0
      k_delta: 4.0
      v_linear_min: 0.9
      v_linear_max: 0.9
