Graduation-Project-2027/Framework-Subteam/src/mecanum_robot_mapping/config/laser_filters_2l.yaml

scan_filter_front:
  ros__parameters:
    filter1:
      name: lift_shadow_front
      type: laser_filters/LaserScanAngularBoundsFilterInPlace
      params:
        lower_angle: -2.35619
        upper_angle: -0.785398

scan_filter_rear:
  ros__parameters:
    filter1:
      name: lift_shadow_rear
      type: laser_filters/LaserScanAngularBoundsFilterInPlace
      params:
        lower_angle: -2.35619
        upper_angle: -0.785398
