Graduation-Project-2027/Framework-Subteam/Hoverboard_Firmware/Src/bldc.c

/*
* This file implements FOC motor control.
* This control method offers superior performanace
* compared to previous cummutation method. The new method features:
* ► reduced noise and vibrations
* ► smooth torque output
* ► improved motor efficiency -> lower energy consumption
*
* Copyright (C) 2019-2020 Emanuel FERU <aerdronix@gmail.com>
*
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
* You should have received a copy of the GNU General Public License
* along with this program.  If not, see <http://www.gnu.org/licenses/>.
*/

#include "stm32f1xx_hal.h"
#include "defines.h"
#include "setup.h"
#include "config.h"
#include "util.h"

// Matlab includes and defines - from auto-code generation
// ###############################################################################
#include "BLDC_controller.h"           /* Model's header file */
#include "rtwtypes.h"

extern RT_MODEL *const rtM_Left;
extern RT_MODEL *const rtM_Right;

extern DW   rtDW_Left;                  /* Observable states */
extern ExtU rtU_Left;                   /* External inputs */
extern ExtY rtY_Left;                   /* External outputs */
extern P    rtP_Left;

extern DW   rtDW_Right;                 /* Observable states */
extern ExtU rtU_Right;                  /* External inputs */
extern ExtY rtY_Right;                  /* External outputs */
// ###############################################################################

static int16_t pwm_margin;              /* This margin allows to have a window in the PWM signal for proper FOC Phase currents measurement */

extern uint8_t ctrlModReq;
static int16_t curDC_max = (I_DC_MAX * A2BIT_CONV);
int16_t curL_phaA = 0, curL_phaB = 0, curL_DC = 0;
int16_t curR_phaB = 0, curR_phaC = 0, curR_DC = 0;

volatile int pwml = 0;
volatile int pwmr = 0;

extern volatile adc_buf_t adc_buffer;

uint8_t buzzerFreq          = 0;
uint8_t buzzerPattern       = 0;
uint8_t buzzerCount         = 0;
volatile uint32_t buzzerTimer = 0;
static uint8_t  buzzerPrev  = 0;
static uint8_t  buzzerIdx   = 0;

uint8_t        enable       = 0;        // initially motors are disabled for SAFETY
static uint8_t enableFin    = 0;

static const uint16_t pwm_res  = 64000000 / 2 / PWM_FREQ; // = 2000

static uint16_t offsetcount = 0;
static int16_t offsetrlA    = 2000;
static int16_t offsetrlB    = 2000;
static int16_t offsetrrB    = 2000;
static int16_t offsetrrC    = 2000;
static int16_t offsetdcl    = 2000;
static int16_t offsetdcr    = 2000;

int16_t        batVoltage       = (400 * BAT_CELLS * BAT_CALIB_ADC) / BAT_CALIB_REAL_VOLTAGE;
static int32_t batVoltageFixdt  = (400 * BAT_CELLS * BAT_CALIB_ADC) / BAT_CALIB_REAL_VOLTAGE << 16;  // Fixed-point filter output initialized at 400 V*100/cell = 4 V/cell converted to fixed-point

#if defined(FEEDBACK_CAN)
volatile int32_t  odomTicksL  = 0;      // hall steps, + = n_mot positive direction. 6 per electrical revolution
volatile int32_t  odomTicksR  = 0;
volatile uint32_t curL_DC_sum = 0;      // wrapping sums of curL_DC / curR_DC, averaged by the reader over curDC_cnt samples
volatile uint32_t curR_DC_sum = 0;
volatile uint32_t curDC_cnt   = 0;
static int8_t     hallPosPrevL = -1;
static int8_t     hallPosPrevR = -1;

// Count hall position steps. Same hall-to-position map and direction convention as the BLDC controller (vec_hallToPos)
static void hallTickCount(uint8_t hallA, uint8_t hallB, uint8_t hallC, int8_t *posPrev, volatile int32_t *ticks) {
  static const int8_t hallToPos[8] = { -1, 2, 0, 1, 4, 3, 5, -1 };  // -1: invalid hall code
  int8_t pos = hallToPos[(hallA << 2) | (hallB << 1) | hallC];

  if (pos < 0) {
    return;
  }
  if (*posPrev >= 0) {
    int8_t d = (int8_t)(pos - *posPrev);
    if (d > 3) {
      d -= 6;
    } else if (d < -3) {
      d += 6;
    }
    if (d != 3 && d != -3) {          // half an electrical revolution between samples: direction unknown, skip
      *ticks += d;
    }
  }
  *posPrev = pos;
}
#endif

// =================================
// DMA interrupt frequency =~ 16 kHz
// =================================
void DMA1_Channel1_IRQHandler(void) {

  DMA1->IFCR = DMA_IFCR_CTCIF1;
  // HAL_GPIO_WritePin(LED_PORT, LED_PIN, 1);
  // HAL_GPIO_TogglePin(LED_PORT, LED_PIN);

  if(offsetcount < 2000) {  // calibrate ADC offsets
    offsetcount++;
    offsetrlA = (adc_buffer.rlA + offsetrlA) / 2;
    offsetrlB = (adc_buffer.rlB + offsetrlB) / 2;
    offsetrrB = (adc_buffer.rrB + offsetrrB) / 2;
    offsetrrC = (adc_buffer.rrC + offsetrrC) / 2;
    offsetdcl = (adc_buffer.dcl + offsetdcl) / 2;
    offsetdcr = (adc_buffer.dcr + offsetdcr) / 2;
    return;
  }

  if (buzzerTimer % 1000 == 0) {  // Filter battery voltage at a slower sampling rate
    filtLowPass32(adc_buffer.batt1, BAT_FILT_COEF, &batVoltageFixdt);
    batVoltage = (int16_t)(batVoltageFixdt >> 16);  // convert fixed-point to integer
  }

  // Get Left motor currents
  curL_phaA = (int16_t)(offsetrlA - adc_buffer.rlA);
  curL_phaB = (int16_t)(offsetrlB - adc_buffer.rlB);
  curL_DC   = (int16_t)(offsetdcl - adc_buffer.dcl);
  
  // Get Right motor currents
  curR_phaB = (int16_t)(offsetrrB - adc_buffer.rrB);
  curR_phaC = (int16_t)(offsetrrC - adc_buffer.rrC);
  curR_DC   = (int16_t)(offsetdcr - adc_buffer.dcr);

  #if defined(FEEDBACK_CAN)
  curL_DC_sum += (uint32_t)(int32_t)curL_DC;
  curR_DC_sum += (uint32_t)(int32_t)curR_DC;
  curDC_cnt++;
  #endif

  // Disable PWM when current limit is reached (current chopping)
  // This is the Level 2 of current protection. The Level 1 should kick in first given by I_MOT_MAX
  if(ABS(curL_DC) > curDC_max || enable == 0) {
    LEFT_TIM->BDTR &= ~TIM_BDTR_MOE;
  } else {
    LEFT_TIM->BDTR |= TIM_BDTR_MOE;
  }

  if(ABS(curR_DC)  > curDC_max || enable == 0) {
    RIGHT_TIM->BDTR &= ~TIM_BDTR_MOE;
  } else {
    RIGHT_TIM->BDTR |= TIM_BDTR_MOE;
  }

  // Create square wave for buzzer
  buzzerTimer++;
  if (buzzerFreq != 0 && (buzzerTimer / 5000) % (buzzerPattern + 1) == 0) {
    if (buzzerPrev == 0) {
      buzzerPrev = 1;
      if (++buzzerIdx > (buzzerCount + 2)) {    // pause 2 periods
        buzzerIdx = 1;
      }
    }
    if (buzzerTimer % buzzerFreq == 0 && (buzzerIdx <= buzzerCount || buzzerCount == 0)) {
      HAL_GPIO_TogglePin(BUZZER_PORT, BUZZER_PIN);
    }
  } else if (buzzerPrev) {
      HAL_GPIO_WritePin(BUZZER_PORT, BUZZER_PIN, GPIO_PIN_RESET);
      buzzerPrev = 0;
  }

  // Adjust pwm_margin depending on the selected Control Type
  if (rtP_Left.z_ctrlTypSel == FOC_CTRL) {
    pwm_margin = 110;
  } else {
    pwm_margin = 0;
  }

  // ############################### MOTOR CONTROL ###############################

  int ul, vl, wl;
  int ur, vr, wr;
  static boolean_T OverrunFlag = false;

  /* Check for overrun */
  if (OverrunFlag) {
    return;
  }
  OverrunFlag = true;

  /* Make sure to stop BOTH motors in case of an error */
  enableFin = enable && !rtY_Left.z_errCode && !rtY_Right.z_errCode;
 
  // ========================= LEFT MOTOR ============================ 
    // Get hall sensors values
    uint8_t hall_ul = !(LEFT_HALL_U_PORT->IDR & LEFT_HALL_U_PIN);
    uint8_t hall_vl = !(LEFT_HALL_V_PORT->IDR & LEFT_HALL_V_PIN);
    uint8_t hall_wl = !(LEFT_HALL_W_PORT->IDR & LEFT_HALL_W_PIN);
    #if defined(FEEDBACK_CAN)
    hallTickCount(hall_ul, hall_vl, hall_wl, &hallPosPrevL, &odomTicksL);
    #endif

    /* Set motor inputs here */
    rtU_Left.b_motEna     = enableFin;
    rtU_Left.z_ctrlModReq = ctrlModReq;  
    rtU_Left.r_inpTgt     = pwml;
    rtU_Left.b_hallA      = hall_ul;
    rtU_Left.b_hallB      = hall_vl;
    rtU_Left.b_hallC      = hall_wl;
    rtU_Left.i_phaAB      = curL_phaA;
    rtU_Left.i_phaBC      = curL_phaB;
    rtU_Left.i_DCLink     = curL_DC;
    // rtU_Left.a_mechAngle   = ...; // Angle input in DEGREES [0,360] in fixdt(1,16,4) data type. If `angle` is float use `= (int16_t)floor(angle * 16.0F)` If `angle` is integer use `= (int16_t)(angle << 4)`
    
    /* Step the controller */
    #ifdef MOTOR_LEFT_ENA    
    BLDC_controller_step(rtM_Left);
    #endif

    /* Get motor outputs here */
    ul            = rtY_Left.DC_phaA;
    vl            = rtY_Left.DC_phaB;
    wl            = rtY_Left.DC_phaC;
  // errCodeLeft  = rtY_Left.z_errCode;
  // motSpeedLeft = rtY_Left.n_mot;
  // motAngleLeft = rtY_Left.a_elecAngle;

    /* Apply commands */
    LEFT_TIM->LEFT_TIM_U    = (uint16_t)CLAMP(ul + pwm_res / 2, pwm_margin, pwm_res-pwm_margin);
    LEFT_TIM->LEFT_TIM_V    = (uint16_t)CLAMP(vl + pwm_res / 2, pwm_margin, pwm_res-pwm_margin);
    LEFT_TIM->LEFT_TIM_W    = (uint16_t)CLAMP(wl + pwm_res / 2, pwm_margin, pwm_res-pwm_margin);
  // =================================================================
  

  // ========================= RIGHT MOTOR ===========================  
    // Get hall sensors values
    uint8_t hall_ur = !(RIGHT_HALL_U_PORT->IDR & RIGHT_HALL_U_PIN);
    uint8_t hall_vr = !(RIGHT_HALL_V_PORT->IDR & RIGHT_HALL_V_PIN);
    uint8_t hall_wr = !(RIGHT_HALL_W_PORT->IDR & RIGHT_HALL_W_PIN);
    #if defined(FEEDBACK_CAN)
    hallTickCount(hall_ur, hall_vr, hall_wr, &hallPosPrevR, &odomTicksR);
    #endif

    /* Set motor inputs here */
    rtU_Right.b_motEna      = enableFin;
    rtU_Right.z_ctrlModReq  = ctrlModReq;
    rtU_Right.r_inpTgt      = pwmr;
    rtU_Right.b_hallA       = hall_ur;
    rtU_Right.b_hallB       = hall_vr;
    rtU_Right.b_hallC       = hall_wr;
    rtU_Right.i_phaAB       = curR_phaB;
    rtU_Right.i_phaBC       = curR_phaC;
    rtU_Right.i_DCLink      = curR_DC;
    // rtU_Right.a_mechAngle   = ...; // Angle input in DEGREES [0,360] in fixdt(1,16,4) data type. If `angle` is float use `= (int16_t)floor(angle * 16.0F)` If `angle` is integer use `= (int16_t)(angle << 4)`
    
    /* Step the controller */
    #ifdef MOTOR_RIGHT_ENA
    BLDC_controller_step(rtM_Right);
    #endif

    /* Get motor outputs here */
    ur            = rtY_Right.DC_phaA;
    vr            = rtY_Right.DC_phaB;
    wr            = rtY_Right.DC_phaC;
 // errCodeRight  = rtY_Right.z_errCode;
 // motSpeedRight = rtY_Right.n_mot;
 // motAngleRight = rtY_Right.a_elecAngle;

    /* Apply commands */
    RIGHT_TIM->RIGHT_TIM_U  = (uint16_t)CLAMP(ur + pwm_res / 2, pwm_margin, pwm_res-pwm_margin);
    RIGHT_TIM->RIGHT_TIM_V  = (uint16_t)CLAMP(vr + pwm_res / 2, pwm_margin, pwm_res-pwm_margin);
    RIGHT_TIM->RIGHT_TIM_W  = (uint16_t)CLAMP(wr + pwm_res / 2, pwm_margin, pwm_res-pwm_margin);
  // =================================================================

  /* Indicate task complete */
  OverrunFlag = false;
 
 // ###############################################################################

}
