Graduation-Project-2027/Framework-Subteam/(commit log)

2026-03-05 Initial commit: Core ROS 2 architecture and Behavior Tree for Framework Subsystem
2026-05-05 Renamed the shitty meccanum robot to AGV, added a scan merger node, corrected lidars filtering, mapping/ navigation in progress
2026-05-06 feat(nav): stabilize navigation and mapping for ROS 2 Jazzy
    - Fixed MPPI controller initialization by correcting motion_model case ('Omni')
    - Resolved collision_monitor segfaults via parameter structure workarounds
    - Tuned costmap inflation_radius (0.55m) to satisfy circumscribed footprint constraints
    - Synchronized Gazebo spawn pose with SLAM Toolbox map_start_pose (-1.545, 1.621)
    - Stabilized dual-lidar scan_merger with TF availability checks
    - Unified navigation simulation launch and cleaned up redundant launch/config files
    - Updated all documentation (README, guide, worklogs) with current AGV package names
2026-06-19 Everything works now, Navigation is solid. GUI has been rehauled --> looks better, functions better
    "redesign rack docking as closed-loop control, fix GUI/SLAM contamination, add LaTeX thesis doc"
    Replace open-loop dead-reckoning docking with closed-loop leg-servo
    control (Procrustes-based rack pose estimation, gated holonomic
    P-control, ratio-based anti-stiction breakaway) to fix unreliable
    centering, hesitant approach, and imprecise placement under racks.
    - mission_manager_node: new _dock_servo/_drive_to_map_point/
    _drive_straight_closed_loop primitives with telemetry logging;
    rewrite _execute_transport around them
    - Add self-calibrating bounding-box scan filter (agv_mapping/
    paylo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
2026-10-28 Added STM32F103RCT6 LQFP64 Datacheet
2026-10-28 Rename AGV to AMR; rebuild mission control GUI with full stack control
    Rename the project from AGV to AMR throughout:
    - Packages agv_* -> amr_* (bringup, description, hardware, interfaces,
    mapping, mission_control, navigation), Python modules, resource
    markers, agv.gazebo -> amr.gazebo, AGV_Software_Documentation.tex ->
    AMR_Software_Documentation.tex, and all code, launch, URDF, config,
    docs and Hoverboard firmware text (286 replacements, whole words only)
    - Launcher variables AMR_MAPS_DIR / AMR_LAUNCHER_PORT; the old AGV_*
    names are still read
    - ~/.ros/amr_* files; on first start the old ~/.ros/agv_locations.json,
    agv_launcher.json and agv_map_trash are migrated automatically
    R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
2026-10-28 Add Blackpill BODY node firmware (e-stop controller) and Blackpill Tool
    - STM32F411CEU6 + MCP2515 firmware (PlatformIO/STM32duino): e-stop
    authority per hardware.md: trips on ESTOP=1, button or 500 ms HB_CMD
    loss, brakes then opens the hoverboard relay, releases only on ESTOP=0
    with the button up, SAFETY_STATUS 0x011 at 10 Hz + on change
    - Register-level MCP2515 driver: bit timing for 8/16/20 MHz crystals,
    in-order RX across both buffers, liveness check and re-init, loopback test
    - USB CDC debug console, MCU watchdog, reboot-to-DFU without BOOT0
    - Host test for the e-stop state machine
    - Blackpill Tool (Tkinter): CAN bitrate/crystal settings, build, SWD and
    DFU upload, ST-Link/DFU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
2026-10-29 Add fleet management: multi-robot traffic, lane layout editor, Pi setup over SSH
    Fleet workspace (laptop runs fleet_server.py, robots run launcher_server.py):
    - Automatic robot discovery (UDP beacon), Robot ID / ROS domain / settings
    stored per robot in ~/.ros/amr_robot.json; identical repo on every robot
    - 3D floor (React Three Fiber): map, racks with entry faces, lanes with
    one-way arrows, robots, reserved floor, holds and back-offs
    - Traffic control (Python + identical JS for Preview): path reservations,
    heartbeat-leased holds, "in the way goes first", back-off along the lane
    or up a rack spur, refuges (under occupied racks when empty, free slots
    when carrying), hold-loop breake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
2026-10-30 Fix fleet traffic hangs: corner probe, unused right of way, rack bays
    Robots could wait forever on a robot that had right of way but never
    moved. Preview's collision probe looked 0.35 m straight past the corner
    where a robot turns into a rack bay, so it stopped for a robot it would
    never reach while the others held for it; traffic control only passed
    right of way on when its own model saw the cause.
    - Preview: probe 0.35 m along the path, around corners
    - Right of way that isn't used passes on: unheld and still for 4 s, it
    goes to the other robot if that one's way is clear of it (never to a
    follower stuck behind it)
    - Stand-offs alternate right of way instead of settling
    - Rack bays: be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
