Graduation-Project-2027/Framework-Subteam/(notices)

Notices in the files:
Hoverboard_Firmware/Src/bldc.c:
This program is free software: you can redistribute it and/or modify
it under the terms of the GNU General Public License as published by
the Free Software Foundation, either version 3 of the License, or
(at your option) any later version.
Hoverboard_Firmware/README.md:
License: GPL v3
